StackingDeezLayers/VoronUsers/printer_mods/Long/Mantis_Dual_5015/STLs/Hotend_Mount_Rapido_v.03_Rotated120Degrees_sherpa_brace.stl

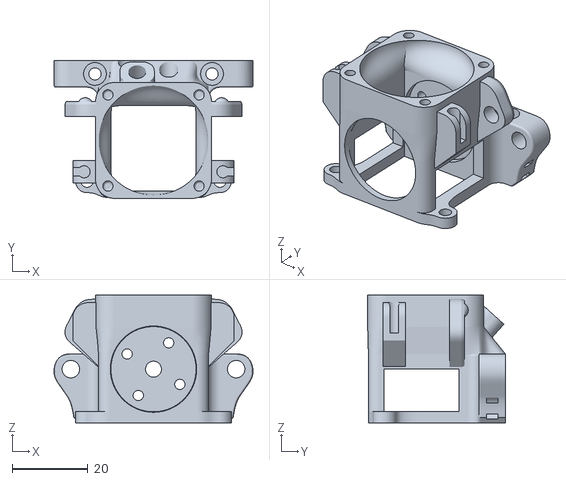
[picture p1: CAD file, 2022-09-04]
printer_mods/Long/Mantis_Dual_5015/STLs/Hotend_Mount_Rapido_v.03_Rotated120Degrees_sherpa_brace.stl
52.4 x 36.2 x 33.7
