StackingDeezLayers/VoronUsers/(commit log)

2022-09-04 Rapido Sherpa Brace Hotend Mount
    Added hotend mount that works with the braced mini sherpa. updated readme and CADs to reflect.
    [Hotend_Mount_Rapido_v.03_Rotated120Degrees_sherpa_brace.stl]
2023-05-10 Update readme.md
    Changed the links to the Y endstop relocation to the current and correct path.
